liziyaaa/balance_ladder/images/README.md

# 图片资源

本目录保存 README、报告和展示材料中可使用的图片。

| 文件 | 用途 |
|---|---|
| `esp32C3核心板.png` | ESP32-C3 SuperMini 引脚/核心板说明 |
| `3D_PCB1_2026-06-22.png` | PCB 3D 预览图 |
| `3D_PCB1_2026-06-22 (1).png` | PCB 3D 预览图 |
| `3D_PCB1_2026-06-22 (2).png` | PCB 3D 预览图 |
| `ChatGPT Image 2026年6月22日 11_46_00.png` | 项目展示/概念图 |
| `ChatGPT Image 2026年6月22日 12_29_14.png` | 项目展示/概念图 |

硬件生产和原理图相关图片保存在 [hardware/](../hardware/) 目录。
