liziyaaa/balance_ladder/hardware/3D_PCB1_2026-06-09 (1).png

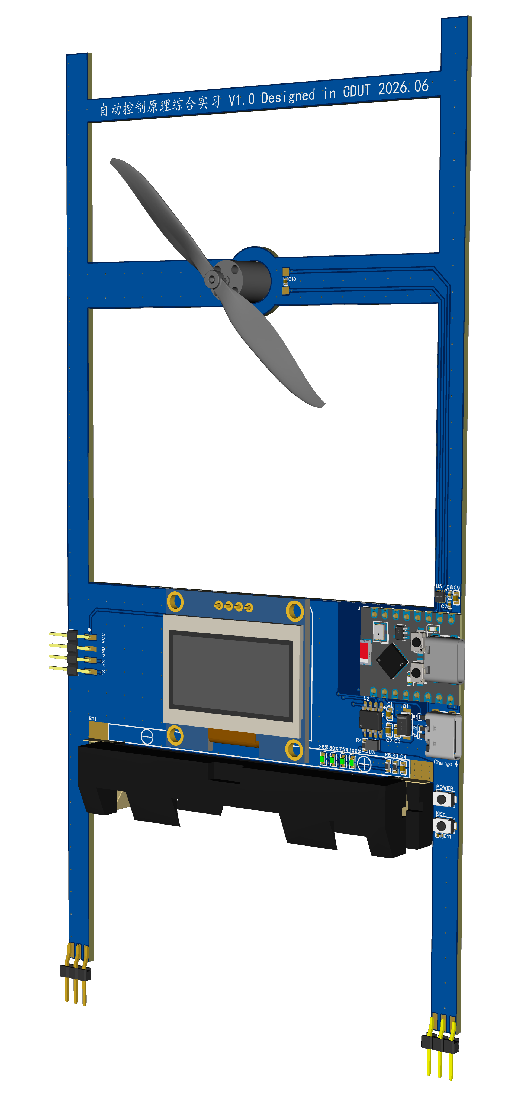
hardware/3D_PCB1_2026-06-09 (1).png
