liziyaaa/balance_ladder/images/3D_PCB1_2026-06-22.png

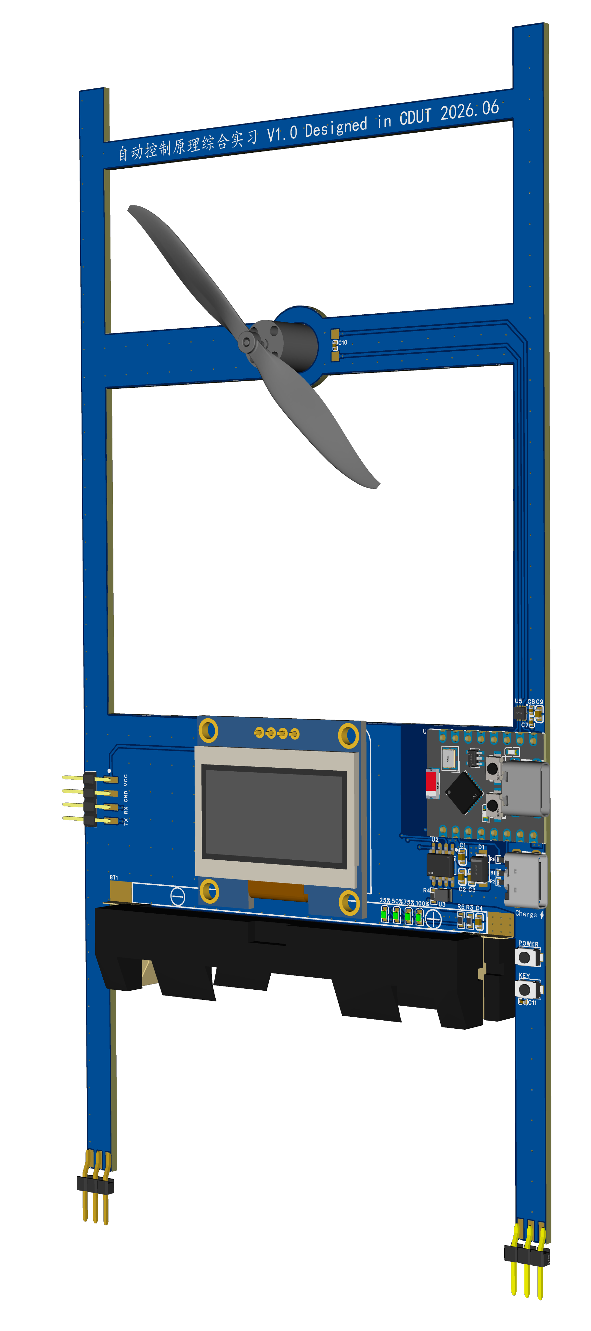
images/3D_PCB1_2026-06-22.png
