liziyaaa/balance_ladder/images/ChatGPT Image 2026年6月22日 11_46_00.png

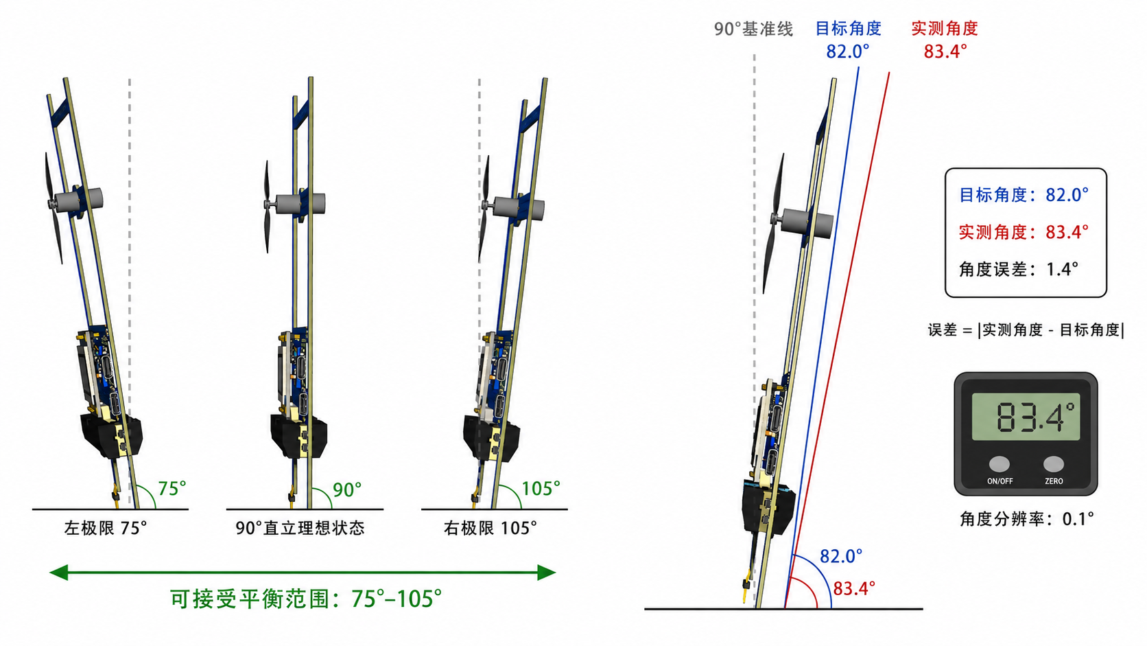
images/ChatGPT Image 2026年6月22日 11_46_00.png
