liziyaaa/balance_ladder/images/ChatGPT Image 2026年6月22日 12_29_14.png

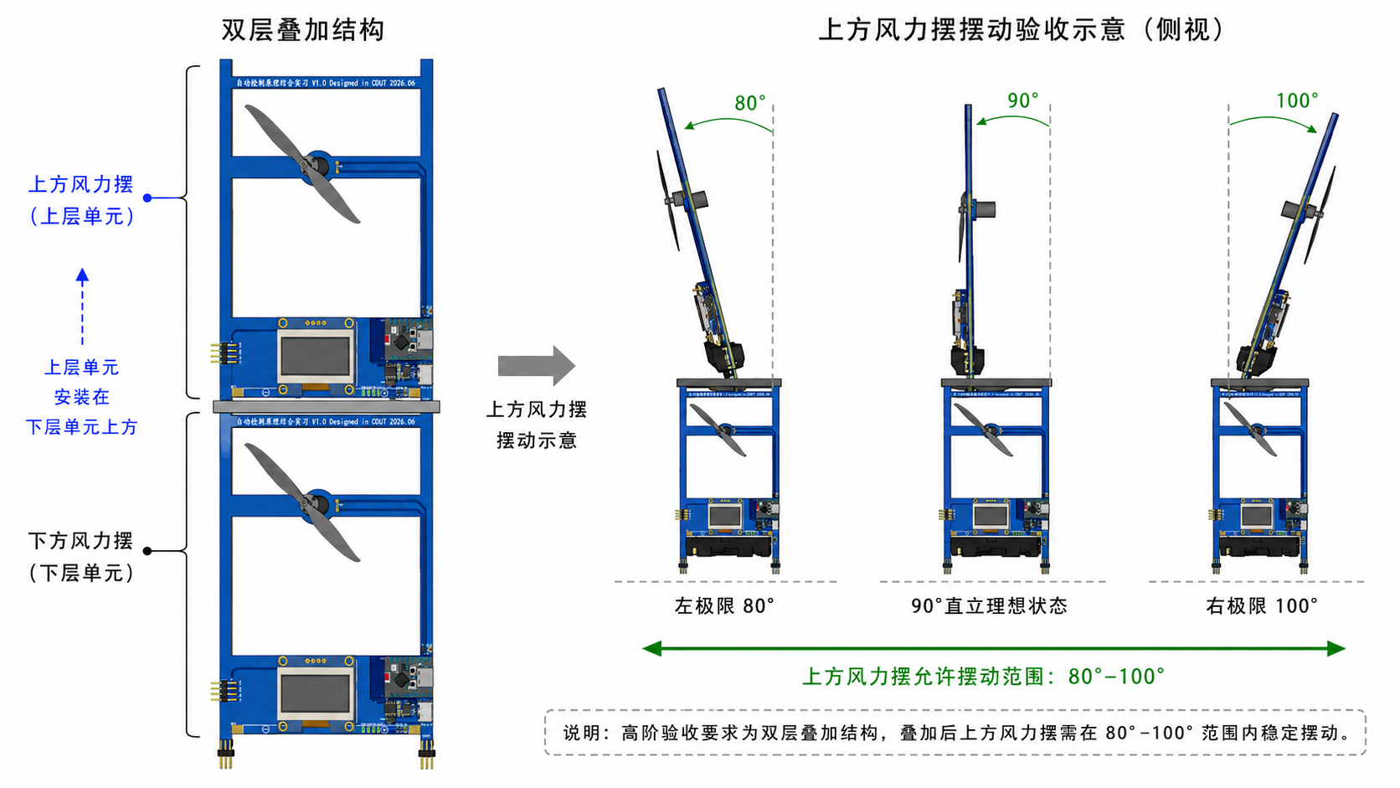
images/ChatGPT Image 2026年6月22日 12_29_14.png
