liziyaaa/balance_ladder/images/esp32C3核心板.png

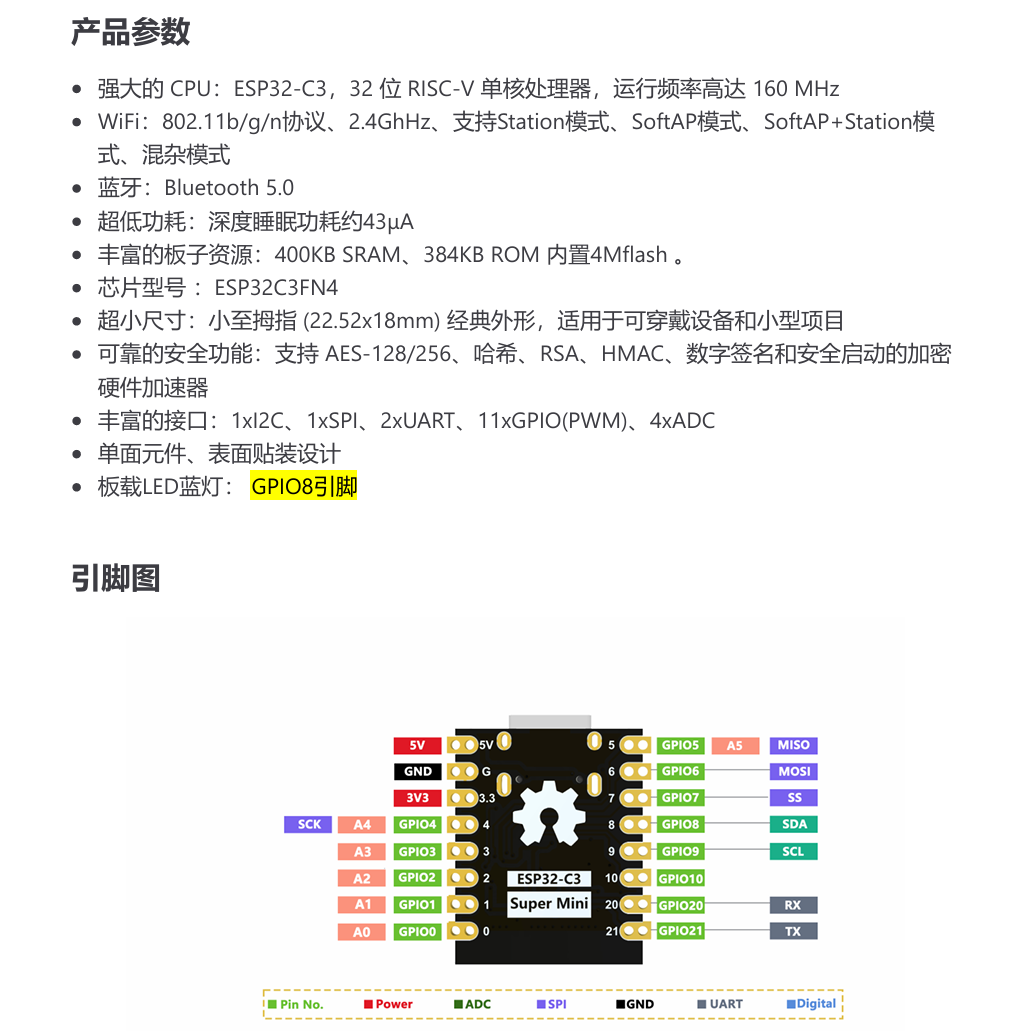
images/esp32C3核心板.png
