liziyaaa/balance_ladder/docs/debug/index.html

Balance Ladder

# 调试助手

未连接

状态 --

角度 --

目标 --

误差 --

角速度 --

电机 --

## 姿态

等待遥测数据

校准视图

X Y Z

误差 / 电机输出 error cmd

## 连接

BLE WiFi

搜索蓝牙设备 连接选中设备

未选择设备。点击“搜索蓝牙设备”，在浏览器弹出的列表中选择要连接的设备。

断开

搜索会打开浏览器蓝牙选择器；页面会保存已授权过的设备，建议使用 Android Chrome 或 Edge。

WebSocket

连接 断开

HTTP 命令

GitHub Pages 下普通 HTTP/WS 可能被浏览器拦截。

## 快捷控制

status defaults level arm stop clear cal auto on auto off

## 参数

target kp ki kd limit gain_pos gain_neg min_pos min_neg kick_pos kick_neg baseline motor

发 target 发 kp 发 ki 发 kd 发 limit 发 g+ 发 g- 发 min+ 发 min- 发 k+ 发 k- 发 base 发 motor

## 命令

发送
