liziyaaa/balance_ladder/hardware/SCH_Schematic1_2026-06-09.pdf

# GPIO1 10 GPIO2 11 GPIO3 12 GPIO4 13 3V3 14 GND 15 5V 16

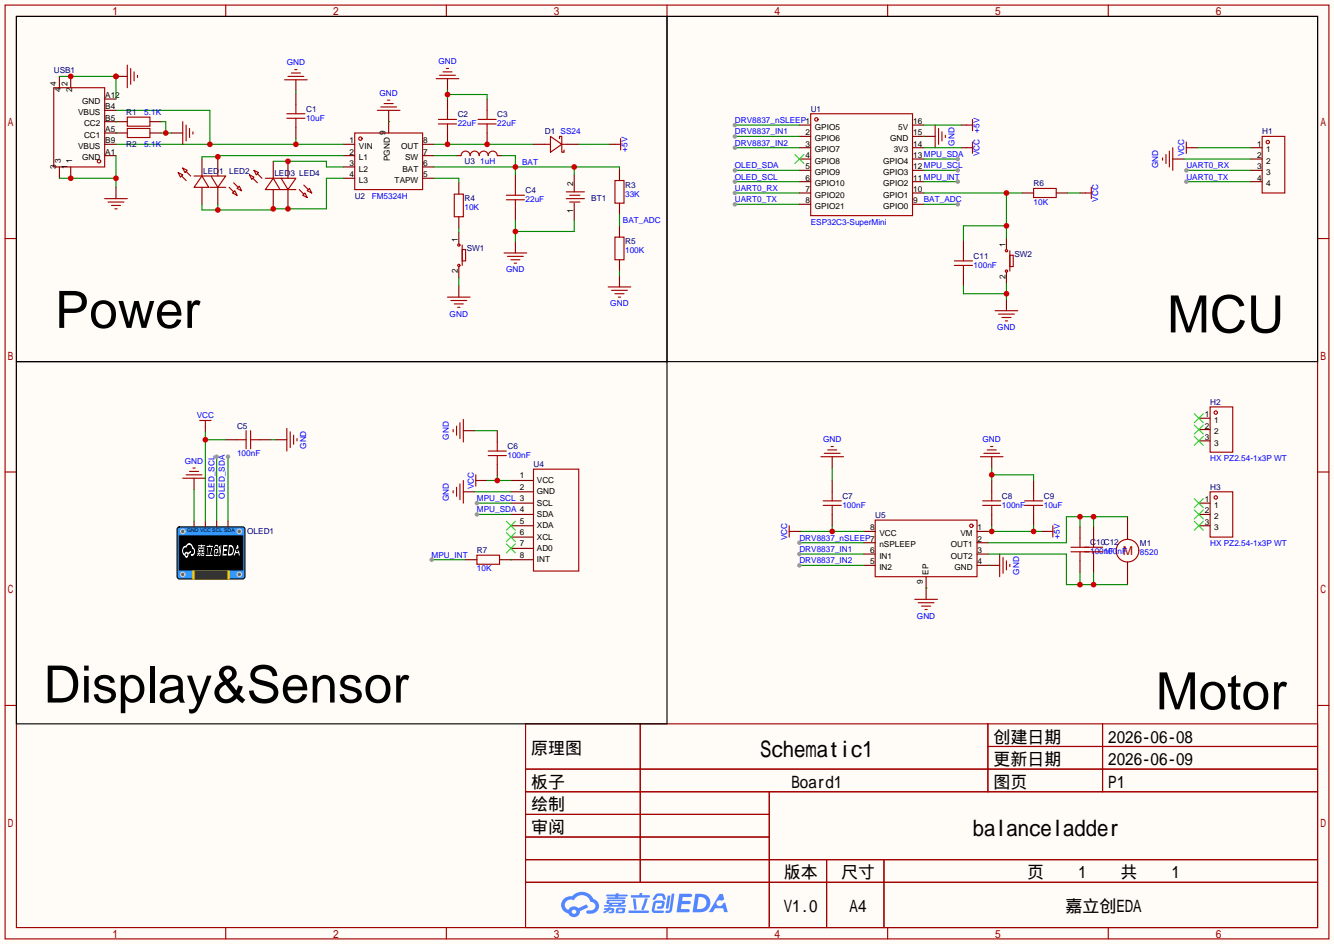
[picture p12: page 1]

BAT GND A1 VBUS B9 CC1 A5 CC2 B5 VBUS B4 GND A12

原理图 | Schematic1 | 创建日期 | 2026-06-08

更新日期 | 2026-06-09

板子 | Board1 | 图页 | P1
绘制 | | balanceladder
审阅

V1.0 | A4 | 嘉立创EDA
