liziyaaa/balance_ladder/(list of files, drawings)

Other design files:
hardware/balanceladder_2026-06-09.epro
