liziyaaa/balance_ladder/(commit log)

2026-06-25 Organize project repository
    [balanceladder_2026-06-09.epro]
2026-06-28 feat: add bluetooth device picker to debug page
2026-06-28 fix balance response tuning
    [app_main.cpp, app_state.cpp, app_state.h, balance_controller.cpp, ble_debug.cpp, imu_mpu6050.cpp, motor_drv8837.cpp]
2026-06-28 add directional motor compensation
